icestationenterprise/campfire-bridge/hardware/phase1/enclosure/preview-base.png

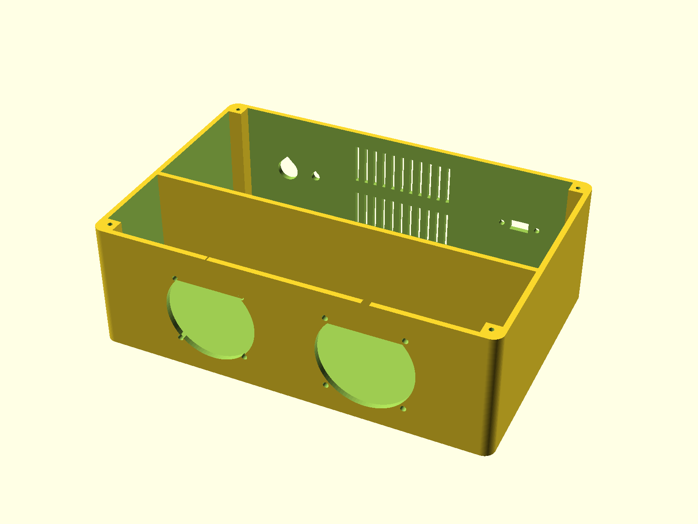
hardware/phase1/enclosure/preview-base.png
