icestationenterprise/campfire-bridge/hardware/phase1/enclosure/campfire-base.stl

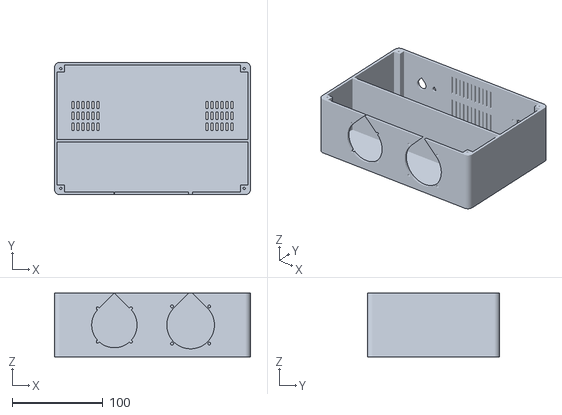
[picture p2: CAD file, 2026-10-22]
hardware/phase1/enclosure/campfire-base.stl
216.0 x 146.0 x 70.0
