icestationenterprise/campfire-bridge/hardware/phase1/enclosure/campfire-lid.stl

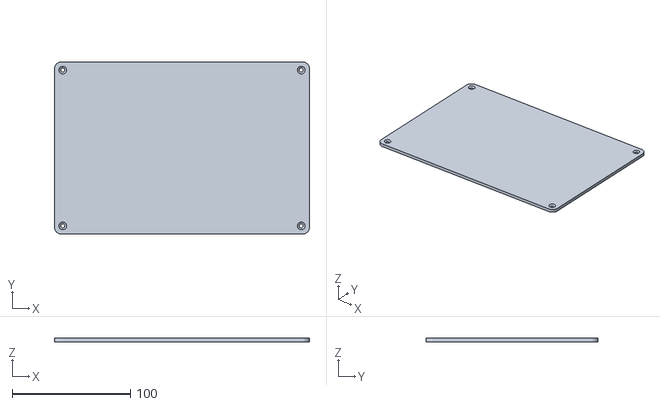
[picture p3: CAD file, 2026-10-22]
hardware/phase1/enclosure/campfire-lid.stl
216.0 x 146.0 x 3.00
