icestationenterprise/campfire-bridge/(commit log)

2026-04-01 Add Pi setup script
    One-command install for Raspberry Pi OS Lite (64-bit) on Pi 5.
    Installs Node 20, librespot, playerctl, PulseAudio+BT, shairport-sync,
    clones and builds the bridge, registers it as a user systemd service.
2026-04-02 Fix bluetoothctl paired-devices command for BlueZ 5.7x+
    Debian Trixie ships BlueZ where `paired-devices` was replaced
    by `devices Paired`. Update listDevices() to use new syntax.
2026-04-21 Add party mode, multi-adapter BT, offline AirPlay, Tailscale setup
    Bridge API:
    - party.ts: PulseAudio null-sink + loopbacks with per-speaker latency calibration
    - adapters.ts: multi-adapter routing; finds which adapter a device is paired on
    before connecting (fixes "Failed to connect via hciX" for ENAV/UART adapter)
    - airplay.ts: start/stop shairport-sync for offline AirPlay mode
    - index.ts: /api/party/*, /api/offline/*, /api/adapters endpoints
    - bluetooth.ts: multi-adapter aware scan/list with interactive pairedForAdapter
    - types.ts: BridgeStatus.offline, PartyStatus, SpeakerState
    App:
    - BridgeContext: party mode, offline party, per-speaker volume/mute/sync
    - DevicesScreen: party mode UI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
2026-04-22 Fix BT connect: don't send quit before Connection successful arrives
    adapters.ts: btctlOn was appending 'quit' to the connect script, causing
    bluetoothctl to exit before BlueZ fires the async "Connection successful"
    notification. Replace connectDevice with attemptConnect that monitors stdout
    and only resolves when a terminal result (or timeout) is seen.
    DevicesScreen: add error catch + red banner so connect/disconnect failures
    are shown to the user instead of becoming unhandled promise rejections.
2026-04-22 Mode switching: Online/Offline auto-switches Bridge URL
    SettingsContext: replace single bridgeUrl with onlineUrl + offlineUrl.
    bridgeUrl is now computed from mode (online→Tailscale IP, offline→192.168.4.1).
    Migrates existing stored bridgeUrl to onlineUrl on first load.
    SettingsScreen: mode toggle auto-switches URL, shows offline setup
    instructions with "Open WiFi Settings" button when Offline is selected.
    Active URL field highlighted in green. No manual URL editing needed for
    normal use.
2026-05-06 Remove AVRCP volume control; simplify to PA-only per-speaker volume
    AVRCP proved unreliable for bidirectional volume sync: speakers accept
    SetAbsoluteVolume commands but don't send notifications on physical
    button presses, making the poll useless. Replace with PA sink volume
    for all speakers — the individual slider always works, physical buttons
    are an independent hardware override (same as any amp knob).
    - Drop avrcp probe, 3s poll timer, and AVRCP imports from party.ts
    - setSpeakerVolume always uses pactl set-sink-volume
    - adjust_time 10→2 on loopback modules (smaller, more frequent rate
    corrections — less audible than one big correction every 10s)
    - Remove avrcp field from Speake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
2026-05-06 Fix BT scan causing A2DP audio dropouts in party mode
    The DevicesScreen auto-scan loop called POST /api/bt/scan every ~12s,
    which ran bluetoothctl inquiry on ALL adapters simultaneously — including
    the adapter actively streaming A2DP to a speaker. Sharing radio time
    between inquiry and audio caused the observed 9s-good/3s-bad choppiness.
    Fixes (layered, belt-and-suspenders):
    1. index.ts — scan guard: when party mode is active, /api/bt/scan
    returns the known paired device list immediately without touching
    any radio. Discovery is never needed while in a party.
    2. bluetooth.ts — scanDevices skips adapters that have a speaker
    assigned via the in-memory assignments map (no syste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
2026-06-17 Remove Spotify and now-playing UI from app
    Deletes SpotifyContext, spotifyAuth service, SpotifyLoginScreen,
    NowPlayingScreen, Player component, and their tests.
    App role shifts to setup/device-management only; playback via AirPlay/Cast.
2026-06-17 Refactor app for AirPlay/Cast architecture; add online/offline mode switching
    BridgeContext strips Spotify/playback state; SettingsContext adds
    onlineUrl/offlineUrl with mode toggle. DevicesScreen and SettingsScreen
    updated to match. mock-bridge and all tests updated to new API shape.
2026-06-17 Add camping mode: auto WiFi/hotspot daemon + NM profile + setup steps
    camping-mode.sh waits 60s at boot for home WiFi; falls back to the
    Campfire hotspot (via NetworkManager shared AP) if none found. Scans
    every 30s in hotspot mode and switches back automatically when a saved
    home network comes in range. State written to /tmp/campfire-network-mode.
    campfire-hotspot.nmconnection configures wlan0 as AP with built-in
    NM dnsmasq for DHCP — no separate hostapd/dnsmasq install needed.
    setup-pi.sh gains step 9/9: installs profile, daemon, and service.
    Also disables the Pi's built-in BT adapter (USB dongles only).
2026-06-17 Add network_mode to /api/status; read live from camping-mode state file
    BridgeStatus gains network_mode: 'home' | 'camping'. The status route
    reads /tmp/campfire-network-mode on every poll so the app always sees
    the current mode without restarting the API.
2026-06-17 Auto-detect network mode in app; switch URLs without user intervention
    BridgeProvider gains fallbackUrl + onFallback props. After 3 consecutive
    failures on the primary URL (3s fetch timeout each), it tries the
    fallback. If the fallback responds, onFallback() is called to persist
    the mode change in settings — so the app silently switches online↔offline
    as the phone moves between home WiFi and the Pi's Campfire hotspot.
    App.tsx wires the alternate URL and a setSetting callback so the roles
    flip correctly when switching back (fallback becomes primary, primary
    becomes fallback).
2026-06-17 Update PLAN.md: current state, check off #3/#4, mark #14 in progress
    Current State table now reflects actual codebase: librespot/Spotify
    removed, Bridge API done, camping-mode daemon partial, app auto-detection
    done. Work order #3 and #4 checked off; #14 marked in-progress with
    note on what's done vs pending (LED/button/serial-suffixed SSID).
2026-06-17 Fix camping-mode daemon: increase reconnect wait, add API request polling
    15s was not long enough for NM to reconnect to home WiFi after the
    hotspot stops — daemon was re-starting the hotspot immediately, causing
    oscillation. Increased to 45s (RECONNECT_WAIT).
    Added handle_api_request(): reads /tmp/campfire-mode-request each loop
    tick and acts on it, so POST /api/network/mode can trigger a switch
    without the API process needing sudo.
2026-06-17 Add POST /api/network/mode endpoint
    Writes a mode request to /tmp/campfire-mode-request. The camping-mode
    daemon picks it up on its next 30s tick and runs the actual nmcli
    commands — no sudo needed from the API process.
2026-06-17 Rename Online/Offline to Home/Camping; replace Tailscale URL with mDNS
    - AppMode: 'online'|'offline' → 'home'|'camping'
    - Settings keys: onlineUrl/offlineUrl → homeUrl/campingUrl
    - Default homeUrl: http://campfire-bridge.local:3000 (was Tailscale IP)
    - SettingsScreen: Home/Camping mode buttons with home/terrain icons
    - AsyncStorage migration: old keys and mode values auto-upgraded on load
2026-06-17 Update PLAN.md current state to reflect camping mode and app renames
2026-09-11 Add #27a hardware characterization to work order, gate BOM finalization on it
2026-10-06 Add hardware cost-down diagnostics harness (#27a)
    Capture/report/constrain tooling plus the BT balance and identify scripts used
    to characterize the Pi 5 rig, with the measured baseline and the E1-E7 results
    table filled in from the 25 recovered runs so #28 has a written spec.
    Findings recorded alongside the method:
    - Corrects the README's single-thread framing. shairport-sync dominates at 26%
    vs pulseaudio 15%, so the workload spreads across cores and multi-core budget
    SoCs stay on the shortlist.
    - E4 fails hard: ~4.2 MB/s sustained writes (~347 GB/day), load-independent and
    present at idle. Flagged as a probable bug to attribute, not a storage spec.
    - E5 inconclusive, camping ran 78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
2026-10-06 E4 confirmed: bridge API writes 4.8 MB/s to the SD card
    Attributed to node (pid 1310) over a 30s window with speakers connected.
    Single matching device, and per-process total matches diskstats within 0.1%,
    so capture.py's 4.2 MB/s across all 25 runs was correct. ~396 GB/day will
    wear out SD/eMMC in the field. Logged as a known issue blocking #28 storage
    sizing. CPU impact is small (node p95 2.0%); the damage is endurance.
2026-10-13 Refactor bridge API onto BlueZ D-Bus; split out pulse/btctl/network modules
    Replace the bluetoothctl-screen-scraping adapters.ts with a single BlueZ
    GetManagedObjects snapshot (bluez.ts) that reports every adapter, device and
    the adapter each speaker is bonded to; bluetoothctl (btctl.ts) is now used
    only for pairing and discovery. Party mode keeps a persistent null sink and
    adds/removes per-speaker loopbacks individually with sink_dont_move, so one
    speaker dropping can no longer feed the party sink back into itself. Routes
    are wrapped so a bad request can never exit the process. Same HTTP contract.
    Verified on the Pi: D-Bus enumeration, connect, party enable, latency nudge
    without interrupt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
2026-10-13 Harden camping mode, add BT channel steering, drop stale deploy files
    camping-mode.sh now requires 4 consecutive scan misses (~2 min) before
    leaving home WiFi, so a brief WiFi blip no longer tears down an active
    AirPlay session, and it never scans or switches while a phone is joined to
    the hotspot. WiFi power save is disabled on wlan0.
    Add bt-afh.sh: the three USB radios sit centimetres from the Pi's WiFi
    antenna and hop across the channels it uses, collapsing the WiFi link while
    speakers stream. It declares the Pi's own 2.4 GHz channel bad to every
    adapter via HCI AFH host classification, re-applying when the channel or
    adapter set changes.
    Point shairport-sync at PulseAudio's default sin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
2026-10-13 Document radio layout requirement, D-Bus API layout, SD-write attribution
    Record the 2026-10-07 finding that three dongles plugged side by side are the
    worst possible radio layout: production needs one class 1 radio per speaker
    spread to the enclosure extremes, and the app should show which radio each
    speaker is on so the device can be oriented. Update the BOM line accordingly.
    Rewrite bridge/README.md for the current layout, and add the fd/fatrace
    commands for attributing the 4.8 MB/s SD write before changing code.
2026-10-13 Add step-by-step runbook and scripts for the four open experiments
    sd-write-attribute.sh separates wchar (syscalls, including sockets) from
    write_bytes (what actually reaches the card) — the distinction that decides
    whether Issue #0 is a real defect or the app's 2 s status poll counted as disk
    traffic. boot-time.sh measures E7 and reports that shairport-sync is only
    started on party enable, so no AirPlay target is advertised after a cold boot
    until #16 lands.
    RUNBOOK.md Part 7 walks E4, E7, E3 and E5 click by click, including cmdline.txt
    backup and SD-card recovery for the RAM-limit reboots, and notes that bt-afh.sh
    now masks the WiFi channel so E5 must be re-measured with it running.
    Ma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
2026-10-13 Record E7 result, fix state detection in sd-write-attribute.sh, log 4 findings
    E7 (a) passes: 15.8 s cold boot, API answering at 12.2 s, 33 s of margin. E7
    (b) cannot be measured — shairport-sync starts only on party enable, so a
    cold-booted device advertises no AirPlay target at all. That makes work-order
    #16 (boot auto-reconnect) a launch gate rather than an optimization, and it is
    now marked as one. Also noted that ~7.8 s of the 12.2 s is removable units
    (NetworkManager-wait-online, cloud-init, tailscaled, ModemManager), so the
    margin is thinner than it looks on a slower board.
    sd-write-attribute.sh was reading a field that does not exist (party.active,
    not party_active) and calling pa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
2026-10-13 E4 does not reproduce; add E6 power script, E8 battery experiment, boot trim
    Matched-state re-measurement (party active, 3 BT sinks, audio playing) shows
    0.0 KB/s to storage from the API and 0.0 KB/s across the whole card. The
    2026-10-06 figure of 4.8 MB/s does not survive re-measurement: no continuous
    write exists in either the old adapters.ts/party.ts or the current code, and
    capture.py's proc_sample() never read per-process I/O, so the "attributed to
    node" half came from a hand-read that was most likely wchar. Issue #0 is
    downgraded and storage sizing for #28 is unblocked, with one loose end — the
    app auto-scans while its Connections tab is focused (DevicesScreen.tsx:149)
    and BlueZ rewr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
2026-10-13 Fix wrong hotspot IP in runbook Part 3D
    The camping capture told you to SSH to 10.42.0.1 (NetworkManager's shared-mode
    default). The campfire-hotspot profile sets a static 192.168.4.1/24, so that
    address never answers — a stall waiting to happen in the E5 re-run.
2026-10-13 Make E6 resumable: one state per invocation
    power-budget.sh was a single interactive session walking six load states, but
    two of those states break the SSH session it runs in — camping mode needs the
    Mac on a different WiFi network, and the boot spike needs the Pi unplugged. The
    procedure could not survive itself.
    Now each state is its own short command appending to a JSONL log, so losing
    SSH, switching networks or stopping for a day costs nothing. Re-running a state
    overwrites it. `./power-budget.sh` with no args shows progress; `report` reads
    the log, takes the last reading per state, and prints PSU rating plus the
    battery sizing table. Runbook 7E rewritten to match, with the order that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
2026-10-15 E6: better state order, and builtin is not blocked on the I2S amp
    A cold boot yields the 'boot' peak and simultaneously lands the Pi in the
    'idle' state, since nothing auto-reconnects yet. Running boot first and then
    ascending speaker count gives one pass with no backtracking, instead of the
    previous order which disconnected speakers and switched networks twice.
    Also clarify two states that were misleading. 'idle' meant no active audio,
    not a stripped device — the USB adapter and dongles stay plugged in. And
    'builtin' works on either the USB audio path or the I2S amp; measuring it on
    USB now and again after the I2S swap recovers the power half of E1's A/B
    baseline, which skipping the PAM8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
2026-10-16 E6: add bsolo state so E1's power delta does not need three speakers
    The dev rig currently has one BT speaker connected (XB23) and memory records
    only two as physically available, so 'extended', 'builtin' and 'camping' are
    all blocked on a third speaker — the same blocker E5 already has.
    bsolo measures the built-in wired speaker alone with no Bluetooth connected.
    (bsolo - idle) is the built-in audio path's power cost with zero BT confound,
    and re-running it after swapping the USB adapter for the MAX98357A gives the
    power half of E1 today rather than whenever a third speaker appears. The
    report prints the delta and excludes bsolo from continuous worst case, since
    it is a diagnostic rather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
2026-10-16 E6 measured (partial); power-budget.sh now rejects impossible readings
    All seven load states measured on the Pi 5. Four are suspect: 'extended'
    recorded 3.59 W, BELOW idle's 3.85 W, which is physically impossible (it was
    run twice, 4.19 then 3.59, and last-wins kept the bad one); 'bsolo' and
    'limited' came in +0.04 W and +0.03 W over idle; and 'camping' landed below
    'builtin' when hostapd should make it the highest continuous state.
    The bsolo result is the important one — +0.04 W means the built-in speaker is
    almost certainly producing no sound, since the USB adapter enumerates in pactl
    whether or not anything is wired to its output. That also makes the recorded
    'builtin' worst case under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
2026-10-17 Add MVP prototype track: SoM-on-carrier path, plan package, patent clock
    Phase 2 section with stages, first-order cost model, FCC and invention-
    disclosure checklists; work items #2a, #27c-#27g; Known Issues #9/#10.
2026-10-17 Cheapest buy-and-wire BOM; correct E6 note (USB speaker is audible)
    Pi 4B 1 GB + 3 RTL8761B dongles + MAX98357A, ~$65-80 vs ~$130-180 dev rig.
    #27c becomes build-that-unit-and-measure instead of a CM4 acceptance run.
2026-10-17 Finished-product hardware design (hardware/README.md); battery in both BOMs
    One-PCB design: CM4 Lite + 3 soldered BT modules + MAX98357A + 1S3P 18650
    with charger/boost/gauge/latch. ~$148 @100, ~$95 @1000. Runtime default 8 h.
    Dongle-vs-module-vs-chip decision recorded: soldered pre-certified modules.
2026-10-17 Label cost tables: contract-assembled vs parts-only self-assembled
2026-10-21 Lightest Certifiable Campfire: manual, shopping list, Phase 1 wiring + enclosure diagrams
    Pi 4B 1 GB (FCC modular 2ABCB-RPI4B) + Ezurio BT851 radios + Go-class
    built-in; STANDARD and EXTENDED first. docs/first-speaker-manual.md is the
    step-by-step path to the first sold unit; hardware/bom and hardware/phase1
    carry the parts list, pin table and diagrams. PLAN.md records the decisions
    and the two branches (pi5-dev-rig = frozen Pi 5 baseline).
2026-10-22 Enclosure: parametric OpenSCAD model + export/print/order instructions
    Two-bay base and flat lid; driver/radiator cutouts from the Peerless and
    Dayton datasheets, bolt circles flagged for measurement.
2026-10-22 Enclosure: rendered STLs (datasheet defaults) and preview
    Re-export after measuring the driver and radiator bolt circles.
